Gitneye/MicroMouse2023/README.md

# MicroMouse2023

Testing

Link to YouTube where video is:
https://youtu.be/hOCshwSb_zQ
