Gitneye/MicroMouse2023/Micromouse_Design_Report.pdf

# Design Report for Micromouse 2023

## 1 Introducon

## I. Micromouse Specificaons

The Micromouse specificaons are:
- The total budget for the Micromouse must not exceed $1, 500AUD.
- The length and width of the mouse must both be under 16cm.
- The height of the mouse must not exceed 8cm.
- The mouse can only be powered via batery.
- The mouse must be controlled via on-board system. External connecon by any-means during a team’s round will result in disqualificaon.

## II. Micromouse Overall Design

The OVERALL COST of the MICROMOUSE was: $121.91

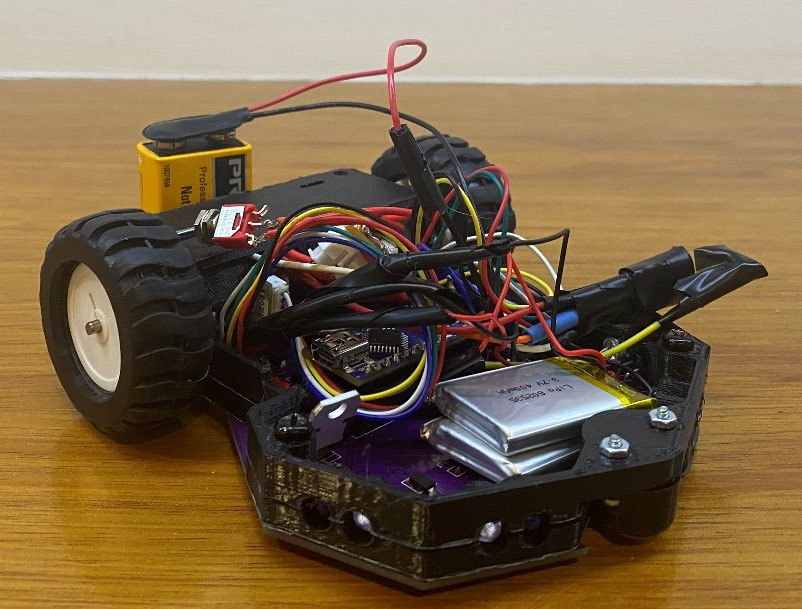
[picture p1: figure]
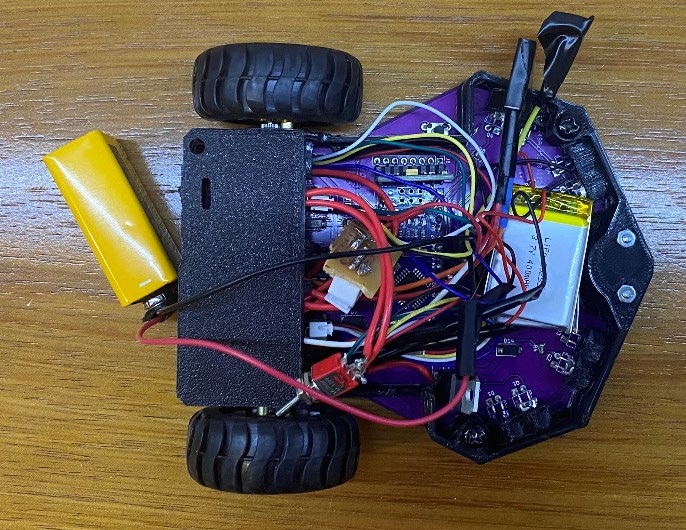
[picture p2: figure]

## 2 Control Design

## I. Main Script

In the ‘main.cpp’ script, the setup declares a one-dimensional array of structures which represents the maze and the cells in the maze. The size of the array is the number of cells in the maze. Inially, all the values in the maze are set to zero. The centre and start of the maze are determined and declared as pointers to the maze array. The goal is also declared as a pointer to the centre pointer. The mouse posion pointer (mousePos) is set to point to the current cell the mouse is in.
The code then enters a while loop of 150 iteraons/movements of the mouse from one cell to the next in the maze. To start, the walls are updated using the update_walls funcon which calls upon the values received from the IR sensors to determine where (if any) walls are about the mouse and updates the current cell to have detected walls. The update_distance funcon then updates the distance of each cell in the maze to the goal. The mouse uses these distances to determine the next cell to move to - which is the neighbouring cell with the shortest distance – which occurs when the to_move funcon is called. It then sets the mouses posion to the cell to be moved to. If the mouse has to rotate, the get_direcon funcon is called to get the required orientaon of the mouse and sets the mouses orientaon to that value.
Once the mouse reaches the centre of the maze (or the goal) it then sets the goal to be the start of the maze and updates distances of each cell based on the goal being the start of the maze. Furthermore, once it reaches the start, the mouse stops.

## II. Update Distance Funcon

The update_distance funcon updates the distance from each cell in the given maze to the given target cell. To do this the funcon uses two buffers to store pointers to cells to be updated, and an array that tracks which cells have been added to either buffer. That is the purpose of the listed and buffers array.
Within the while loop, the funcon updates the distances of each cell in the buffer assigned to the parents pointer. For each cell in the parents buffer, every other cell reachable from it (not blocked by a wall) that hasn't already been listed is added to the buffer assigned to the children pointer. For every loop iteraon, the children buffer is overwriten.
Per iteraon, aer every parent cell in the parents buffer has been updated and their children added to the children buffer the which variable is toggled and the distance variable is incremented. Next iteraon the buffer that was previously the children buffer is now the parent buffer. Their distances are updated, and their children are added to the buffer that was previously the parents buffer.
This process connues unl every cell in the maze has been listed and updated.
To see the code please follow the link below to the GitHub repository: htps://github.com/qcuc/MicroMouse2023/tree/84a416fa76fc7899c37ee69f3e4619b706d999/Na vigaon (https://github.com/qcuc/MicroMouse2023/tree/84a416fa76fc7899c37efbe69f3e4619b706d999/Navigation)

## 3 Electrical Design

## I. Motor & Control Design

For the drive, two brushed geared motors were connected to a L293D motor driver. The motor driver was controlled by the Arduino Nano with PWM signal being supplied to the enable pins to control the speed of the motors and adjusng the digital output to the input pins to control the direcon. To block any electrical regeneraon from the motors, diodes were used. The motors had encoders so that the number of rotaons could be tracked.

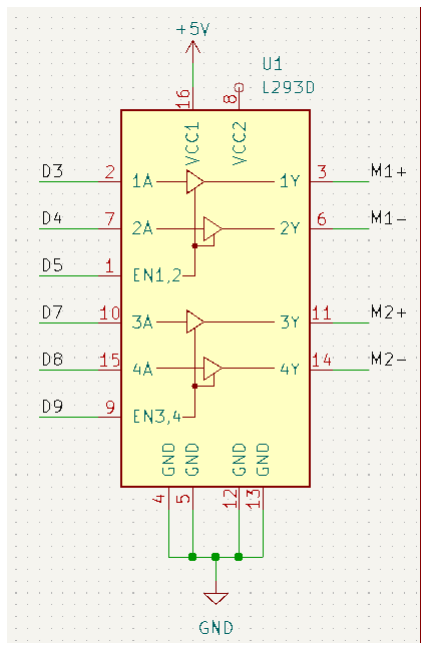
[picture p3: figure]
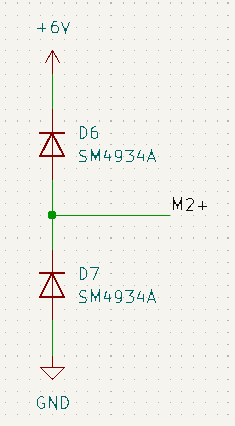
[picture p4: figure]

Micro Metal Geared Motor w/Encoder
- Current Rang: 170 mA
- No-Load Current: 60 mA
- Rated Voltage: 6.0 V

## II. Power Supply Design

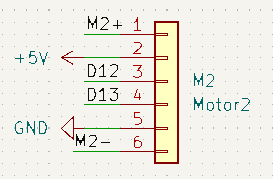
[picture p5: figure]

To supply power for the system, two LiPo bateries (supply voltage – 3.7V, capacity – 400mAh) were connected in series to provide the system with 7.4V and 400mAh. To ensure the one-way flow of power a 1N5408 diode was used as it is appropriate for 3A. The switch was used to connect/disconnect the power. This then flowed through to the linear voltage regulator and electrolyc capacitors to provide a smooth +6V output to the Micromouse.

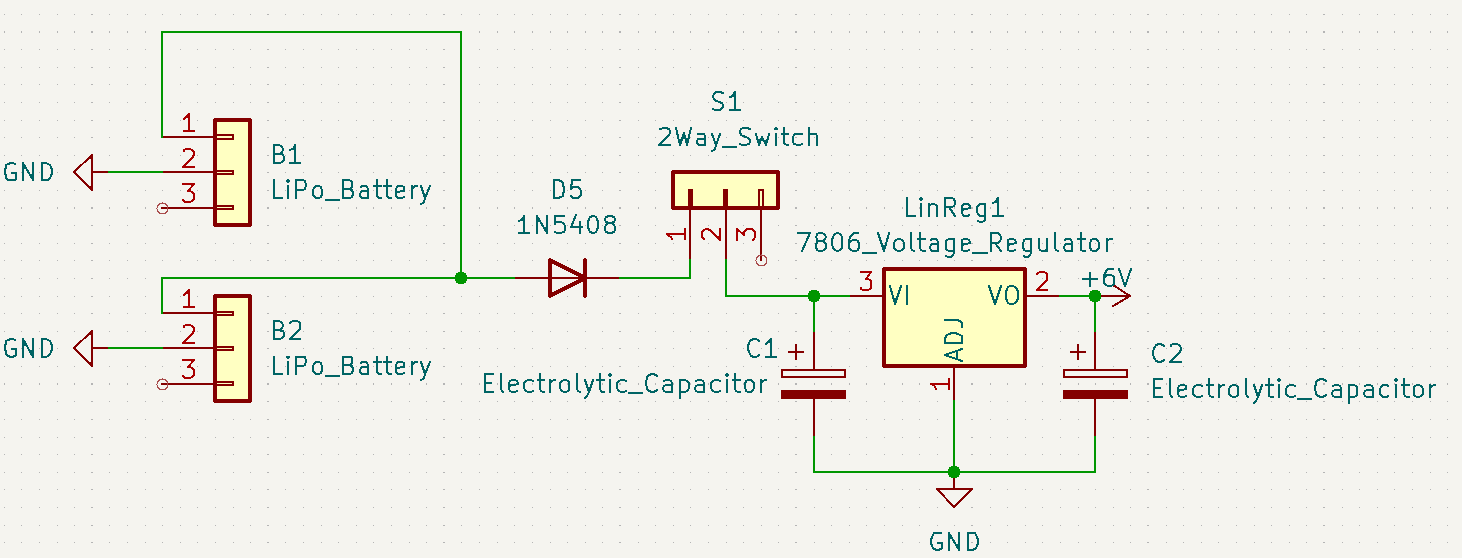
[picture p6: figure]

## III. Start Buton Design

To ensure safety and control on the Micromouse a push buton switch was used to start the program for the rover. The schemac for it is shown below:

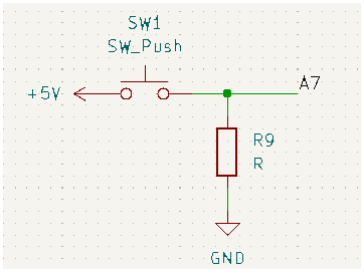
[picture p7: figure]

## IV. Sensor Design

For the distance sensors, 5mm Infrared Transming LEDs and 5mm Infrared Phototransistors were used in conjuncon. To ensure that the power was evenly distributed to the LEDs , they were connected in series from +9V (+L) to GND. The phototransistors were setup such that +5V flows into the collector of the phototransistor, then the emiter is connected to an analogue read pin of the Arduino Nano and a 10kΩ resistor which then runs to GND. This would work by the walls reflecng the light produced by the LEDs to increase the gate voltage and thus the current passing through the phototransistor. This increase in current would then generate a voltage change which can be measured at the analogue read pin of the Arduino nano.

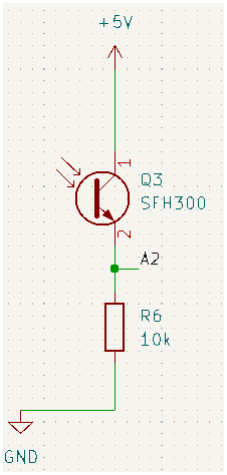
[picture p8: figure]

5mm Infrared Transming LED
- Forward Voltage: 1.2 V (typical), 1.5 V(max)
- Forward Current: 50 mA
- Peak Forward Current: 1.2 A
- Power Dissipaon: 100 mW
- Reverse Voltage: 5 V
- Operang Temperature: -40֯C – 85֯C
5mm Infrared Phototransistor
- Collector-to-Emiter Breakdown Voltage: 30 V
- Emiter-to-Collector Breakdown Voltage: 5 V
- Collector-to-Emiter Saturaon Voltage 0.8 V
- Collector Dark Current: 100 nA

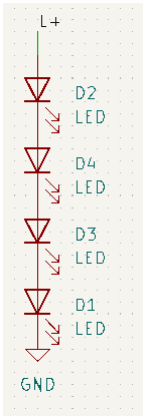
[picture p9: figure]

- On State Collector Current: 0.1 mA (min), 0.5 mA (typical)

## V. PCB Design W/O Filled Zones

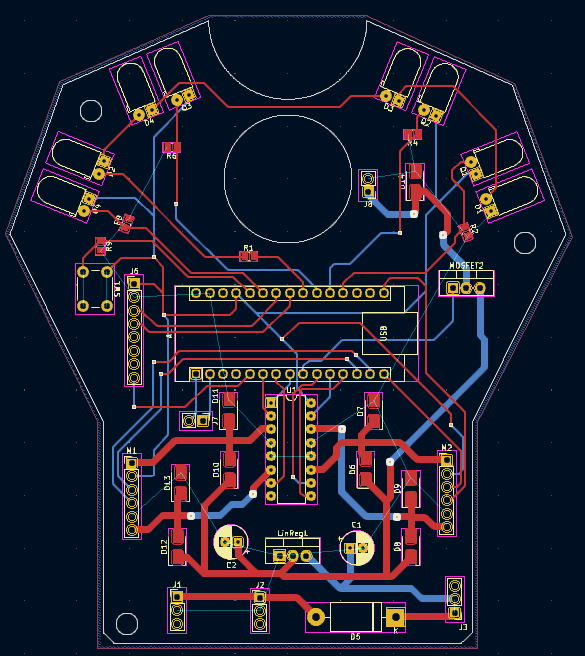
[picture p10: figure]

## W/ Filled Zones

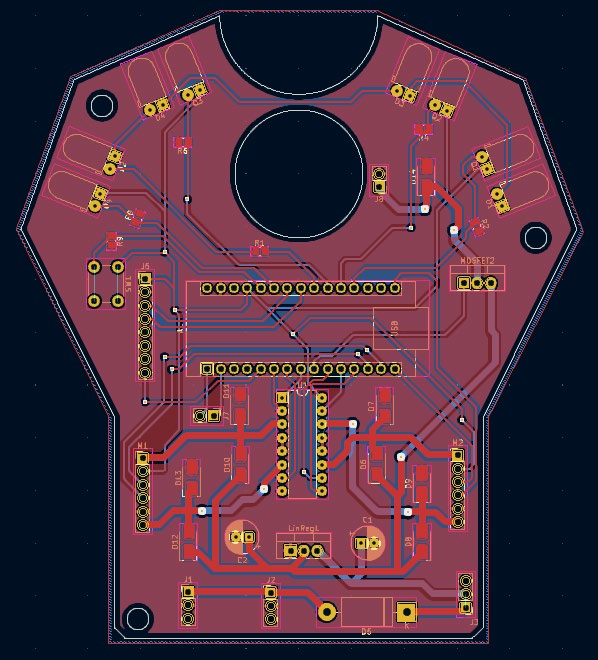
[picture p11: figure]

## 4 Mechanical Design

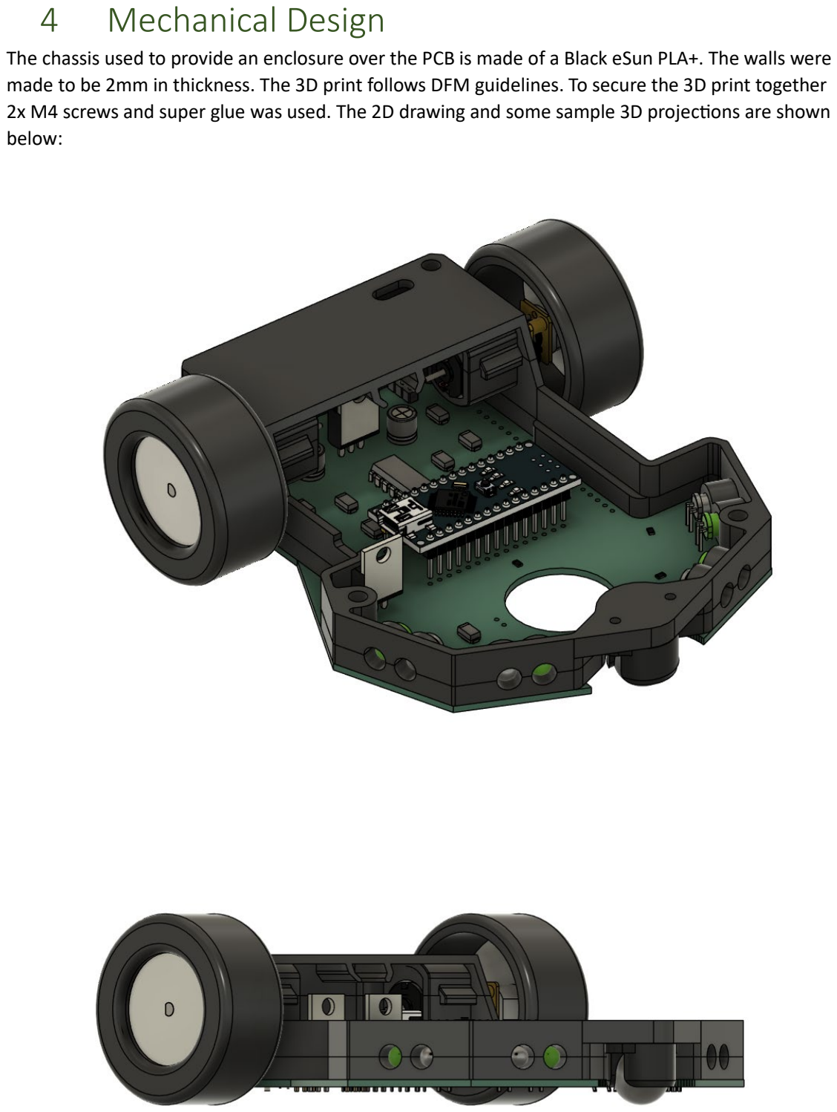
[picture p12: page 9]

The chassis used to provide an enclosure over the PCB is made of a Black eSun PLA+. The walls were made to be 2mm in thickness. The 3D print follows DFM guidelines. To secure the 3D print together 2x M4 screws and super glue was used. The 2D drawing and some sample 3D projecons are shown below:

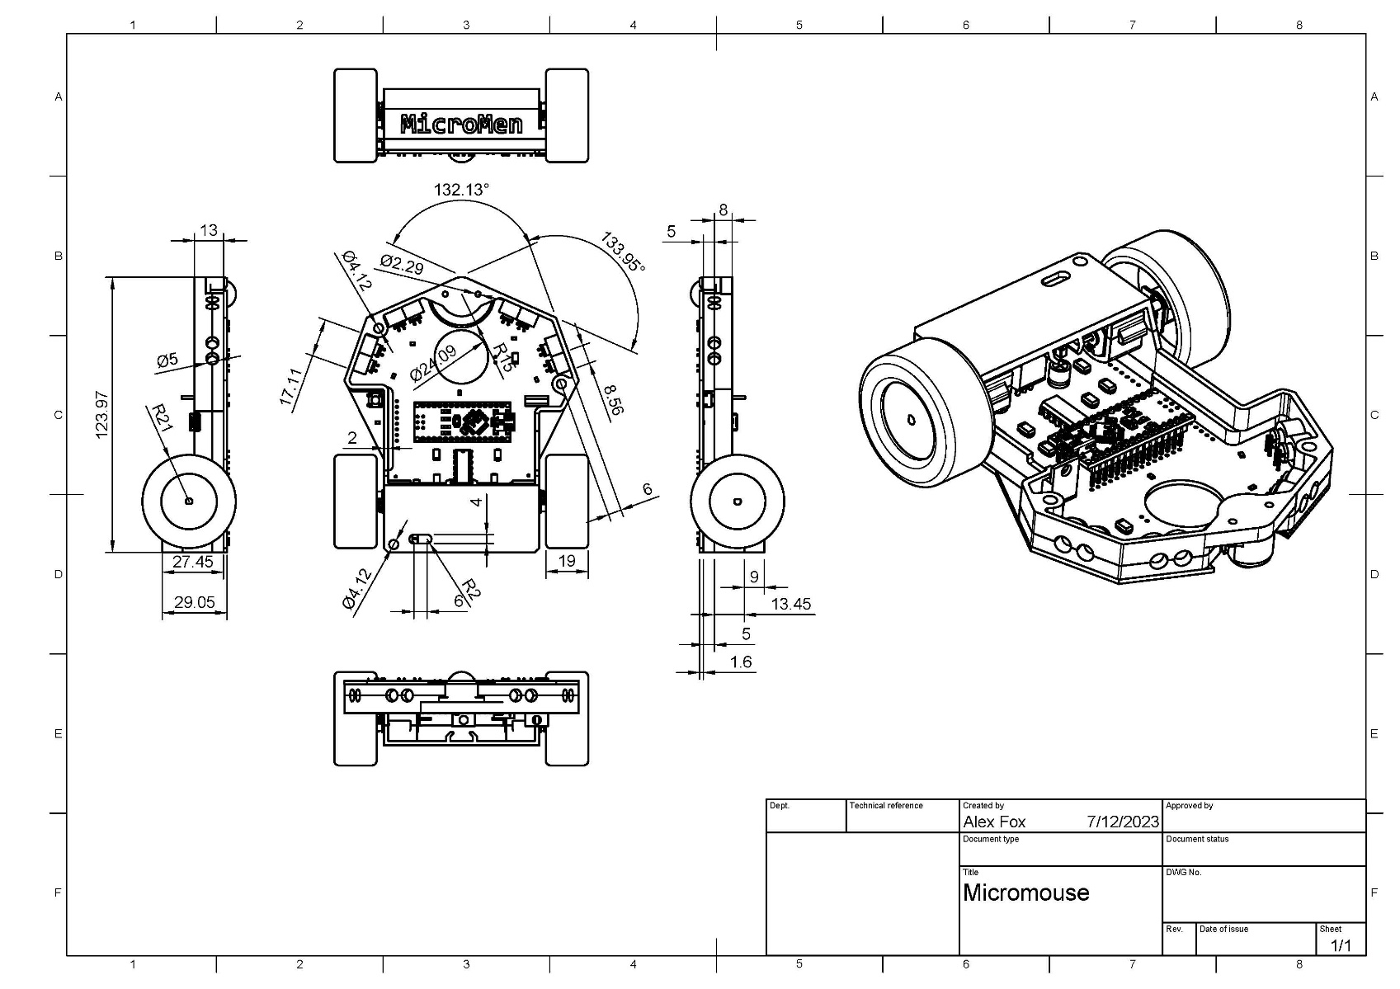
[picture p13: figure]

## Appendix A: CAD Models

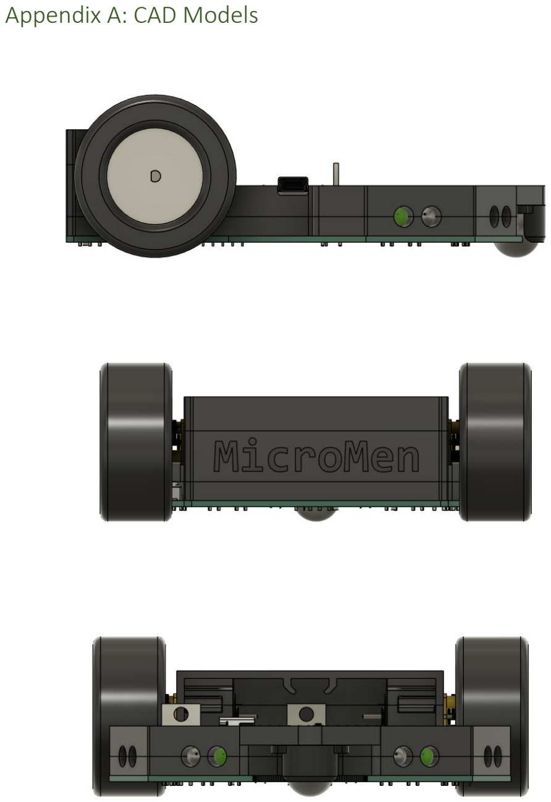
[picture p14: page 11]
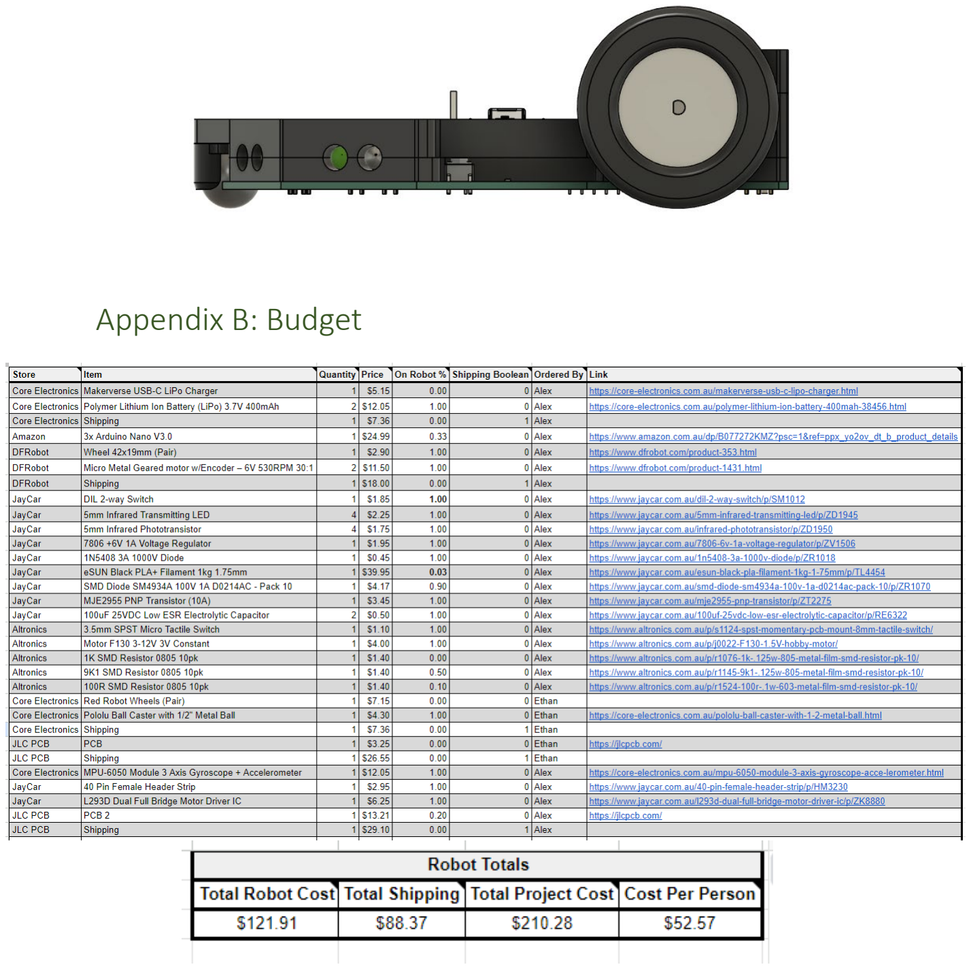
[picture p15: page 12]

## Appendix B: Budget
