Gitneye/MicroMouse2023/Micromouse_Budget.xlsx

Store | Item | Quantity | Price | On Robot % | Shipping Boolean | Ordered By | Link | ON ROBOT Cost | SHIPPING Cost | SUM Cost | Alex Fox | Calum Davis | Ethan Ney | Jack Mills | Robot Totals
Core Electronics | Makerverse USB-C LiPo Charger | 1 | $5.15 | 0.00 | 0 | Alex | https://core-electronics.com.au/makerverse-usb-c-lipo-charger.html | $0.00 | $0.00 | $0.00 | $0.00 | $0.00 | $0.00 | $0.00 | Total Robot Cost | Total Shipping | Total Project Cost | Cost Per Person
Core Electronics | Polymer Lithium Ion Battery (LiPo) 3.7V 400mAh | 2 | $12.05 | 1.00 | 0 | Alex | https://core-electronics.com.au/polymer-lithium-ion-battery-400mah-38456.html | $24.10 | $0.00 | $24.10 | $24.10 | $0.00 | $0.00 | $0.00 | $121.91 | $88.37 | $210.28 | $52.57
Core Electronics | Shipping | 1 | $7.36 | 0.00 | 1 | Alex |  | $0.00 | $7.36 | $7.36 | $7.36 | $0.00 | $0.00 | $0.00
Amazon | 3x Arduino Nano V3.0 | 1 | $24.99 | 0.33 | 0 | Alex | https://www.amazon.com.au/dp/B077272KMZ?psc=1&ref=ppx_yo2ov_dt_b_product_details | $8.33 | $0.00 | $8.33 | $8.33 | $0.00 | $0.00 | $0.00 | Personal Totals
DFRobot | Wheel 42x19mm (Pair) | 1 | $2.90 | 1.00 | 0 | Alex | https://www.dfrobot.com/product-353.html | $2.90 | $0.00 | $2.90 | $2.90 | $0.00 | $0.00 | $0.00 | Alex Fox | Calum Davis | Ethan Ney | Jack Mills
DFRobot | Micro Metal Geared motor w/Encoder – 6V 530RPM 30:1 | 2 | $11.50 | 1.00 | 0 | Alex | https://www.dfrobot.com/product-1431.html | $23.00 | $0.00 | $23.00 | $23.00 | $0.00 | $0.00 | $0.00 | $172.07 | $0.00 | $38.21 | $0.00
DFRobot | Shipping | 1 | $18.00 | 0.00 | 1 | Alex |  | $0.00 | $18.00 | $18.00 | $18.00 | $0.00 | $0.00 | $0.00 | Difference
JayCar | DIL 2-way Switch | 1 | $1.85 | 1.00 | 0 | Alex | https://www.jaycar.com.au/dil-2-way-switch/p/SM1012 | $1.85 | $0.00 | $1.85 | $1.85 | $0.00 | $0.00 | $0.00 | OWED | PAY | PAY | PAY
JayCar | 5mm Infrared Transmitting LED | 4 | $2.25 | 1.00 | 0 | Alex | https://www.jaycar.com.au/5mm-infrared-transmitting-led/p/ZD1945 | $9.00 | $0.00 | $9.00 | $9.00 | $0.00 | $0.00 | $0.00 | $119.50 | -$52.57 | -$14.36 | -$52.57
JayCar | 5mm Infrared Phototransistor | 4 | $1.75 | 1.00 | 0 | Alex | https://www.jaycar.com.au/infrared-phototransistor/p/ZD1950 | $7.00 | $0.00 | $7.00 | $7.00 | $0.00 | $0.00 | $0.00
JayCar | 7806 +6V 1A Voltage Regulator | 1 | $1.95 | 1.00 | 0 | Alex | https://www.jaycar.com.au/7806-6v-1a-voltage-regulator/p/ZV1506 | $1.95 | $0.00 | $1.95 | $1.95 | $0.00 | $0.00 | $0.00
JayCar | 1N5408 3A 1000V Diode | 1 | $0.45 | 1.00 | 0 | Alex | https://www.jaycar.com.au/1n5408-3a-1000v-diode/p/ZR1018 | $0.45 | $0.00 | $0.45 | $0.45 | $0.00 | $0.00 | $0.00
JayCar | eSUN Black PLA+ Filament 1kg 1.75mm | 1 | $39.95 | 0.03 | 0 | Alex | https://www.jaycar.com.au/esun-black-pla-filament-1kg-1-75mm/p/TL4454 | $1.00 | $0.00 | $1.00 | $1.00 | $0.00 | $0.00 | $0.00
JayCar | SMD Diode SM4934A 100V 1A D0214AC - Pack 10 | 1 | $4.17 | 0.90 | 0 | Alex | https://www.jaycar.com.au/smd-diode-sm4934a-100v-1a-d0214ac-pack-10/p/ZR1070 | $3.75 | $0.00 | $3.75 | $3.75 | $0.00 | $0.00 | $0.00
JayCar | MJE2955 PNP Transistor (10A) | 1 | $3.45 | 1.00 | 0 | Alex | https://www.jaycar.com.au/mje2955-pnp-transistor/p/ZT2275 | $3.45 | $0.00 | $3.45 | $3.45 | $0.00 | $0.00 | $0.00
JayCar | 100uF 25VDC Low ESR Electrolytic Capacitor | 2 | $0.50 | 1.00 | 0 | Alex | https://www.jaycar.com.au/100uf-25vdc-low-esr-electrolytic-capacitor/p/RE6322 | $1.00 | $0.00 | $1.00 | $1.00 | $0.00 | $0.00 | $0.00
Altronics | 3.5mm SPST Micro Tactile Switch | 1 | $1.10 | 1.00 | 0 | Alex | https://www.altronics.com.au/p/s1124-spst-momentary-pcb-mount-8mm-tactile-switch/ (https://www.jaycar.com.au/3-5mm-spst-micro-tactile-switch/p/SP0602) | $1.10 | $0.00 | $1.10 | $1.10 | $0.00 | $0.00 | $0.00
Altronics | Motor F130 3-12V 3V Constant | 1 | $4.00 | 1.00 | 0 | Alex | https://www.altronics.com.au/p/j0022-F130-1.5V-hobby-motor/ | $4.00 | $0.00 | $4.00 | $4.00 | $0.00 | $0.00 | $0.00
Altronics | 1K SMD Resistor 0805 10pk | 1 | $1.40 | 0.00 | 0 | Alex | https://www.altronics.com.au/p/r1076-1k-.125w-805-metal-film-smd-resistor-pk-10/ | $0.00 | $0.00 | $0.00 | $0.00 | $0.00 | $0.00 | $0.00
Altronics | 9K1 SMD Resistor 0805 10pk | 1 | $1.40 | 0.50 | 0 | Alex | https://www.altronics.com.au/p/r1145-9k1-.125w-805-metal-film-smd-resistor-pk-10/ | $0.70 | $0.00 | $0.70 | $0.70 | $0.00 | $0.00 | $0.00
Altronics | 100R SMD Resistor 0805 10pk | 1 | $1.40 | 0.10 | 0 | Alex | https://www.altronics.com.au/p/r1524-100r-.1w-603-metal-film-smd-resistor-pk-10/ | $0.14 | $0.00 | $0.14 | $0.14 | $0.00 | $0.00 | $0.00
Core Electronics | Red Robot Wheels (Pair) | 1 | $7.15 | 0.00 | 0 | Ethan |  | $0.00 | $0.00 | $0.00 | $0.00 | $0.00 | $0.00 | $0.00
Core Electronics | Pololu Ball Caster with 1/2" Metal Ball | 1 | $4.30 | 1.00 | 0 | Ethan | https://core-electronics.com.au/pololu-ball-caster-with-1-2-metal-ball.html | $4.30 | $0.00 | $4.30 | $0.00 | $0.00 | $4.30 | $0.00
Core Electronics | Shipping | 1 | $7.36 | 0.00 | 1 | Ethan |  | $0.00 | $7.36 | $7.36 | $0.00 | $0.00 | $7.36 | $0.00
JLC PCB | PCB | 1 | $3.25 | 0.00 | 0 | Ethan | https://jlcpcb.com/ | $0.00 | $0.00 | $0.00 | $0.00 | $0.00 | $0.00 | $0.00
JLC PCB | Shipping | 1 | $26.55 | 0.00 | 1 | Ethan |  | $0.00 | $26.55 | $26.55 | $0.00 | $0.00 | $26.55 | $0.00
Core Electronics | MPU-6050 Module 3 Axis Gyroscope + Accelerometer | 1 | $12.05 | 1.00 | 0 | Alex | https://core-electronics.com.au/mpu-6050-module-3-axis-gyroscope-acce-lerometer.html | $12.05 | $0.00 | $12.05 | $12.05 | $0.00 | $0.00 | $0.00
JayCar | 40 Pin Female Header Strip | 1 | $2.95 | 1.00 | 0 | Alex | https://www.jaycar.com.au/40-pin-female-header-strip/p/HM3230 | $2.95 | $0.00 | $2.95 | $2.95 | $0.00 | $0.00 | $0.00
JayCar | L293D Dual Full Bridge Motor Driver IC | 1 | $6.25 | 1.00 | 0 | Alex | https://www.jaycar.com.au/l293d-dual-full-bridge-motor-driver-ic/p/ZK8880 | $6.25 | $0.00 | $6.25 | $6.25 | $0.00 | $0.00 | $0.00
JLC PCB | PCB 2 | 1 | $13.21 | 0.20 | 0 | Alex | https://jlcpcb.com/ | $2.64 | $0.00 | $2.64 | $2.64 | $0.00 | $0.00 | $0.00
JLC PCB | Shipping | 1 | $29.10 | 0.00 | 1 | Alex |  | $0.00 | $29.10 | $29.10 | $29.10 | $0.00 | $0.00 | $0.00
 |  |  |  |  |  |  |  | $0.00 | $0.00 | $0.00 | $0.00 | $0.00 | $0.00 | $0.00
 |  |  |  |  |  |  |  | $0.00 | $0.00 | $0.00 | $0.00 | $0.00 | $0.00 | $0.00
 |  |  |  |  |  |  |  | $0.00 | $0.00 | $0.00 | $0.00 | $0.00 | $0.00 | $0.00
 |  |  |  |  |  |  |  | $0.00 | $0.00 | $0.00 | $0.00 | $0.00 | $0.00 | $0.00
 |  |  |  |  |  |  |  | $0.00 | $0.00 | $0.00 | $0.00 | $0.00 | $0.00 | $0.00
 |  |  |  |  |  |  |  | $0.00 | $0.00 | $0.00 | $0.00 | $0.00 | $0.00 | $0.00
 |  |  |  |  |  |  |  | $0.00 | $0.00 | $0.00 | $0.00 | $0.00 | $0.00 | $0.00
 |  |  |  |  |  |  |  | $0.00 | $0.00 | $0.00 | $0.00 | $0.00 | $0.00 | $0.00
 |  |  |  |  |  |  |  | $0.00 | $0.00 | $0.00 | $0.00 | $0.00 | $0.00 | $0.00
 |  |  |  |  |  |  |  | $0.00 | $0.00 | $0.00 | $0.00 | $0.00 | $0.00 | $0.00
 |  |  |  |  |  |  |  | $0.00 | $0.00 | $0.00 | $0.00 | $0.00 | $0.00 | $0.00
 |  |  |  |  |  |  |  | $0.00 | $0.00 | $0.00 | $0.00 | $0.00 | $0.00 | $0.00
 |  |  |  |  |  |  |  | $0.00 | $0.00 | $0.00 | $0.00 | $0.00 | $0.00 | $0.00
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
 |  |  |  |  |  |  |  | $0.00 | $0.00 | $0.00 | $0.00 | $0.00 | $0.00 | $0.00
 |  |  |  |  |  |  |  | $0.00 | $0.00 | $0.00 | $0.00 | $0.00 | $0.00 | $0.00
 |  |  |  |  |  |  |  | $0.00 | $0.00 | $0.00 | $0.00 | $0.00 | $0.00 | $0.00
