Gitneye/MicroMouse2023/Schematic.pdf

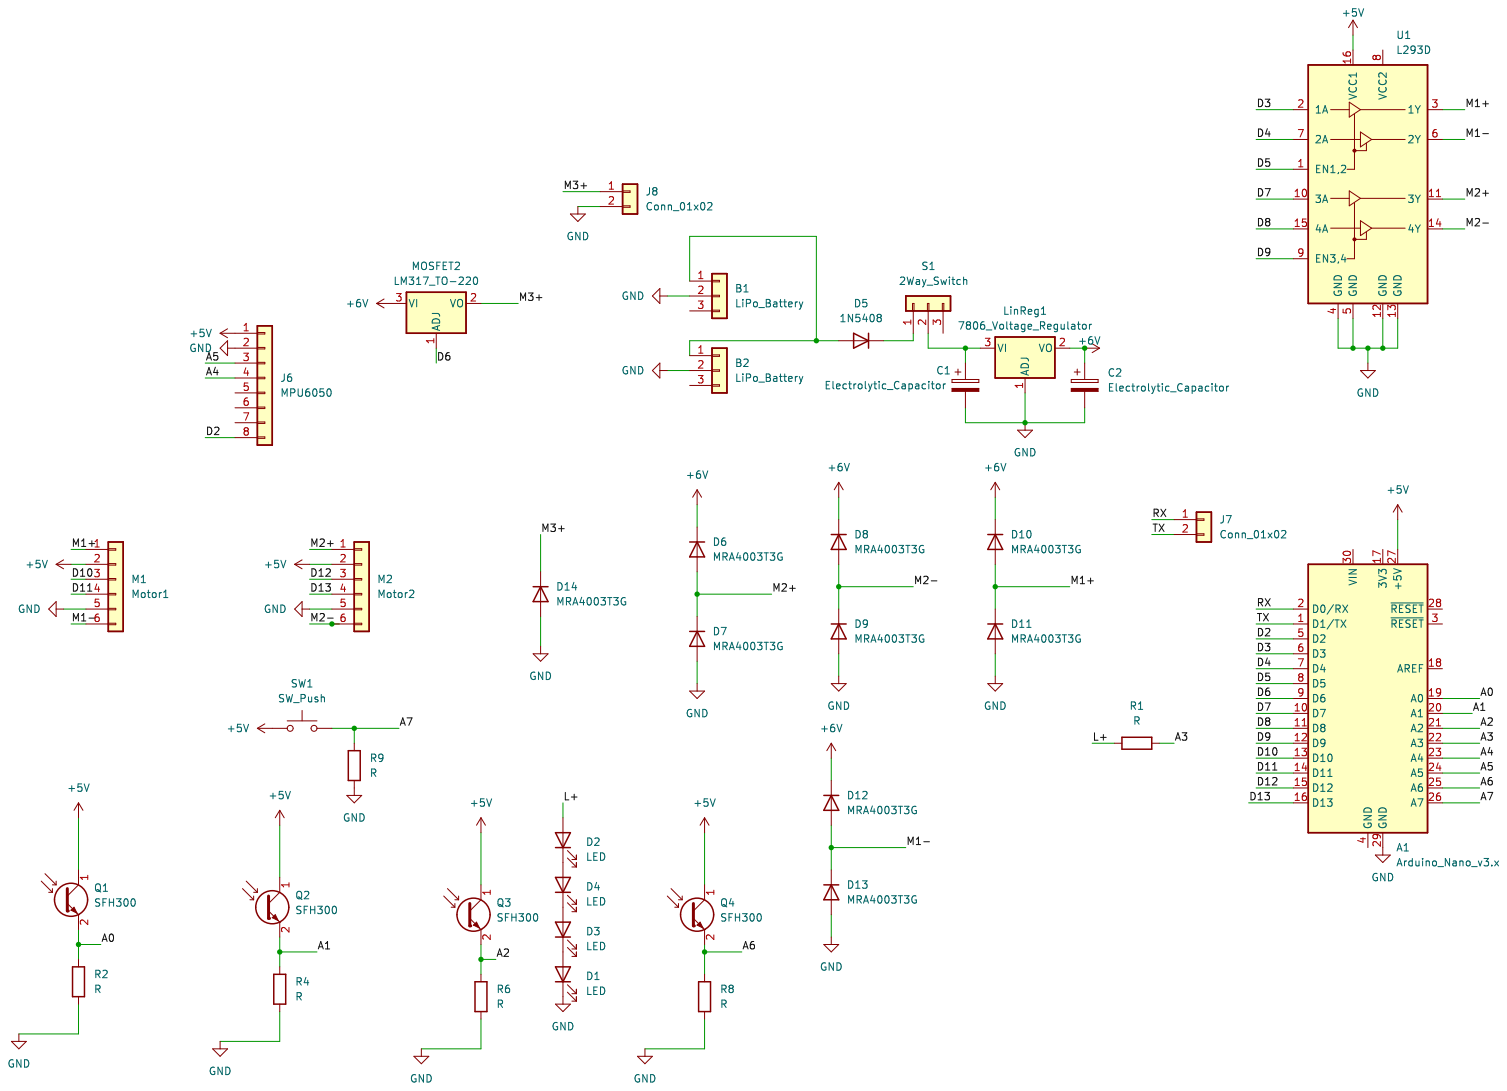
[picture p16: page 1]
