Gitneye/MicroMouse2023/(commit log)

2023-11-21 Added arduino file
2023-11-21 added motor code
2023-12-05 Added schematic pdf
